Rorchive/E06/mechanics/E06-PCB.step

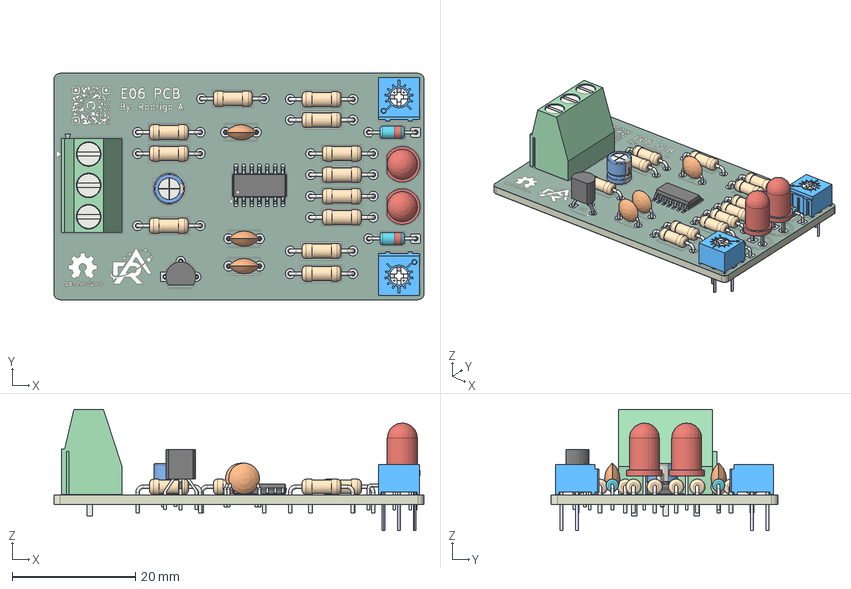
[picture p2: CAD file, 2026-11-11]
mechanics/E06-PCB.step
60.0 x 36.7 x 19.6 mm
R_Axial_DIN0207_L63mm_D25mm_P1016mm_Horizontal x 12
CP_Radial_D50mm_P200mm
C_Disc_D50mm_W25mm_P500mm x 3
3362P-1-103 x 2
D_DO-35_SOD27_P7.62mm_Horizontal x 2
TO-92_Wide
SOIC-14_3.9x8.7mm_P1.27mm
LED_D5.0mm x 2
TerminalBlock_Phoenix_MKDS-1,5-3-5.08_1x03_P5.08mm_Horizontal
E06-PCB_copper
E06-PCB_pad
E06-PCB_silkscreen
E06-PCB_soldermask x 2
E06-PCB_PCB
