Rorchive/E06/hardware/fabrication/B.Cu.pdf

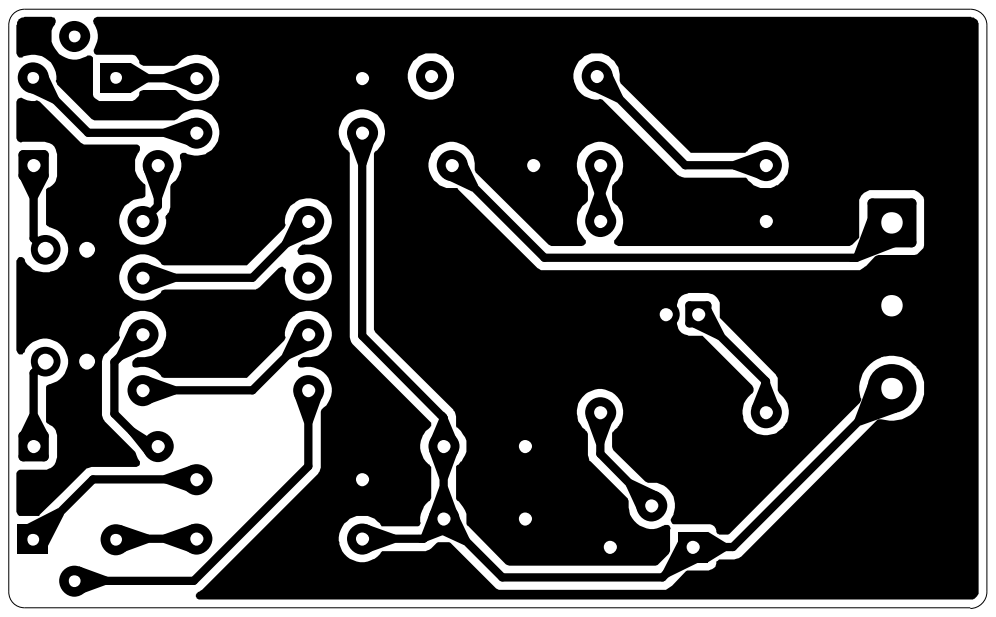
[picture p3: page 1]
