Rorchive/E06/hardware/fabrication/F.Cu.pdf

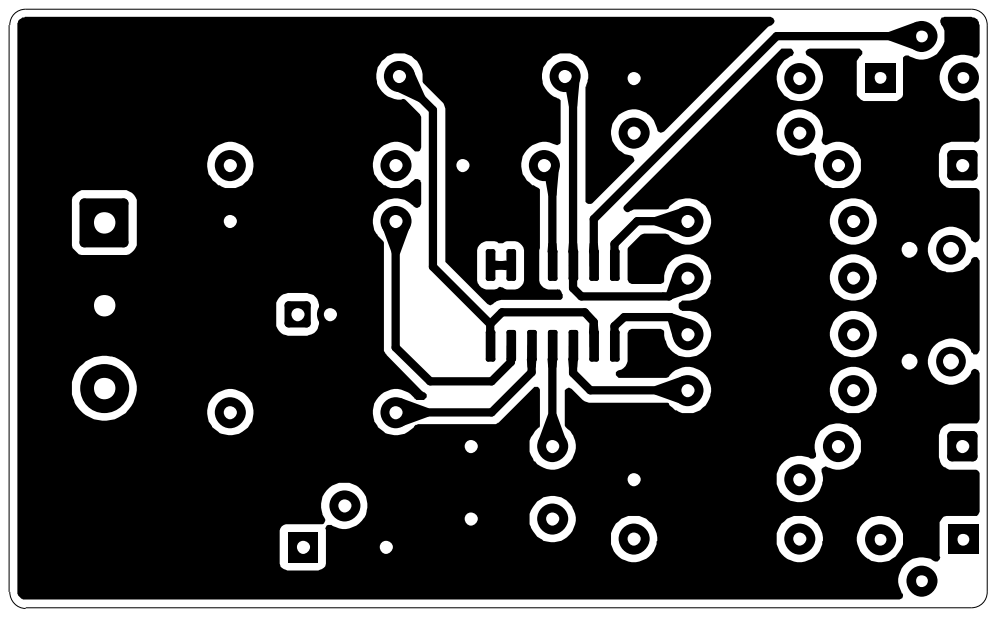
[picture p4: page 1]
