Rorchive/E06/hardware/sources/E06-PCB.kicad_pcb

## KiCad design hardware/sources/E06-PCB.kicad_pcb (2026-11-11)

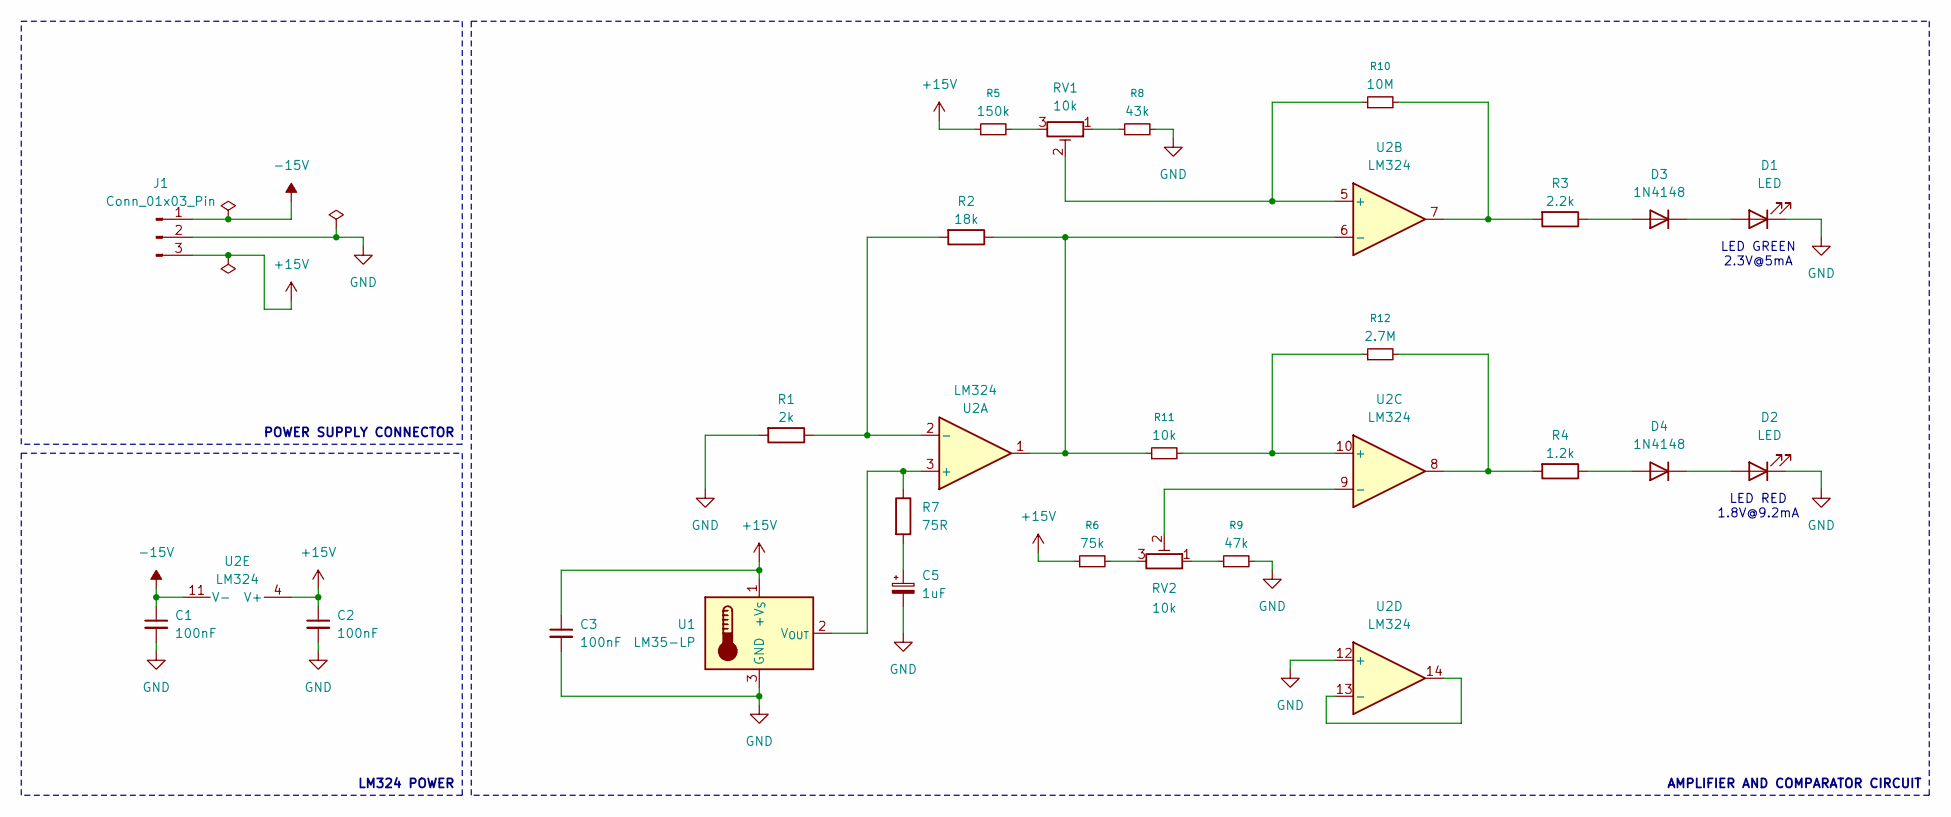
[picture p5: schematic E06-PCB.kicad_sch]

Parts:
C1, C2, C3: 100nF; C_Disc_D5.0mm_W2.5mm_P5.00mm
C5: 1uF; CP_Radial_D5.0mm_P2.00mm
D1, D2: LED; LED_D5.0mm
D3, D4: 1N4148; D_DO-35_SOD27_P7.62mm_Horizontal
J1: Conn_01x03_Pin; TerminalBlock_Phoenix_MKDS-1,5-3-5.08_1x03_P5.08mm_Horizont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
R1: 2k; R_Axial_DIN0207_L6.3mm_D2.5mm_P10.16mm_Horizontal
R2: 18k; R_Axial_DIN0207_L6.3mm_D2.5mm_P10.16mm_Horizontal
R3: 2.2k; R_Axial_DIN0207_L6.3mm_D2.5mm_P10.16mm_Horizontal
R4: 1.2k; R_Axial_DIN0207_L6.3mm_D2.5mm_P10.16mm_Horizontal
R5: 150k; R_Axial_DIN0207_L6.3mm_D2.5mm_P10.16mm_Horizontal
R6: 75k; R_Axial_DIN0207_L6.3mm_D2.5mm_P10.16mm_Horizontal
R7: 75R; R_Axial_DIN0207_L6.3mm_D2.5mm_P10.16mm_Horizontal
R8: 43k; R_Axial_DIN0207_L6.3mm_D2.5mm_P10.16mm_Horizontal
R9: 47k; R_Axial_DIN0207_L6.3mm_D2.5mm_P10.16mm_Horizontal
R10: 10M; R_Axial_DIN0207_L6.3mm_D2.5mm_P10.16mm_Horizontal
R11: 10k; R_Axial_DIN0207_L6.3mm_D2.5mm_P10.16mm_Horizontal
R12: 2.7M; R_Axial_DIN0207_L6.3mm_D2.5mm_P10.16mm_Horizontal
RV1, RV2: 10k; TRIM_3362P-1-103LF
U1: LM35-LP; TO-92_Wide
U2: LM324; SOIC-14_3.9x8.7mm_P1.27mm

Connections:
+15V: C2.1, C3.1, J1.3, R5.1, R6.1, U1.1 (+V_{S}), U2.4 (V+)
-15V: C1.1, J1.1, U2.11 (V-)
GND: C1.2, C2.2, C3.2, C5.2, D1.1 (K), D2.1 (K), J1.2, R1.2, R8.2, R9.2, U1.3 (GND), U2.12 (+)
unnamed: C5.1, R7.2
unnamed: D1.2 (A), D3.1 (K)
unnamed: D2.2 (A), D4.1 (K)
unnamed: D3.2 (A), R3.1
unnamed: D4.2 (A), R4.1
unnamed: R5.2, RV1.3
unnamed: R6.2, RV2.3
unnamed: R8.1, RV1.1
unnamed: R9.1, RV2.1
unnamed: R3.2, R10.2, U2.7
unnamed: R4.2, R12.2, U2.8
unnamed: R7.1, U1.2 (V_{OUT}), U2.3 (+)
unnamed: R1.1, R2.2, U2.2 (-)
unnamed: R10.1, RV1.2, U2.5 (+)
unnamed: R2.1, R11.1, U2.1, U2.6 (-)
unnamed: R11.2, R12.1, U2.10 (+)
unnamed: RV2.2, U2.9 (-)
unnamed: U2.13 (-), U2.14

Notes on the sheet:
LED RED 1.8V@9.2mA
LED GREEN 2.3V@5mA
AMPLIFIER AND COMPARATOR CIRCUIT
LM324 POWER
POWER SUPPLY CONNECTOR

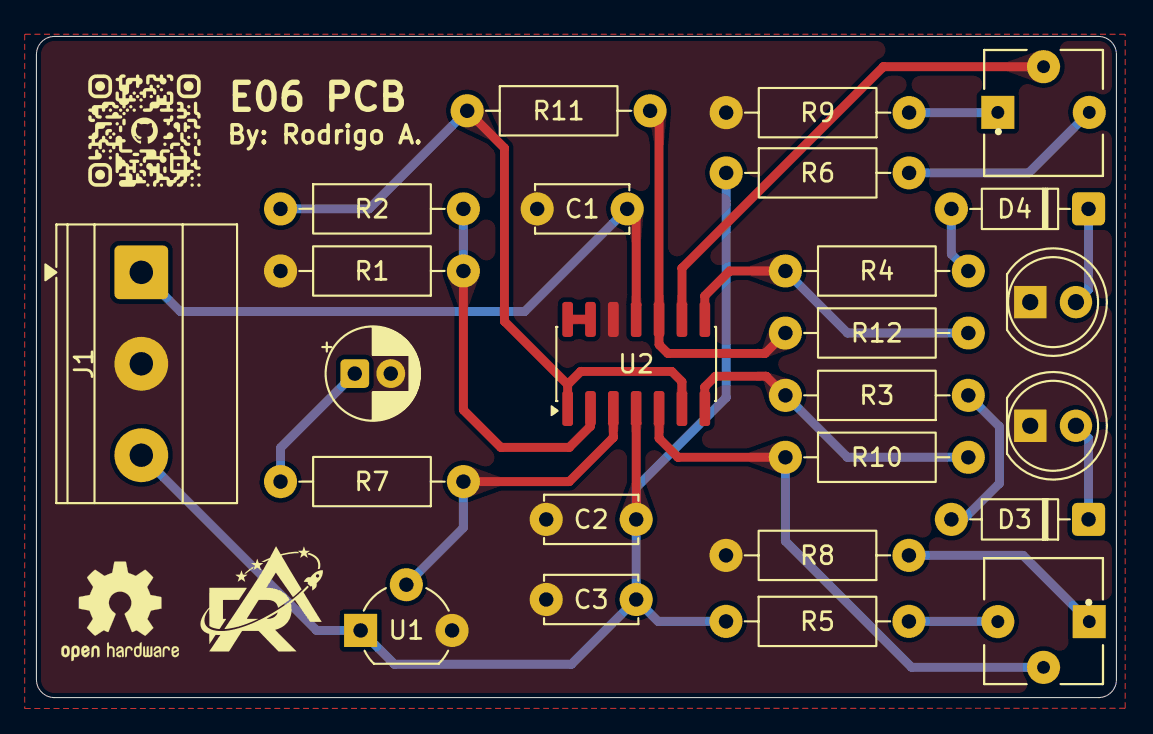
[picture p6: board E06-PCB.kicad_pcb from above]

Board: 2 copper layers, 60.0 x 36.7 mm, 25 parts (0 on the bottom side), 21 nets.
