Rorchive/E06/(commit log)

2026-11-09 feat(hardware): start PCB layout
    [E06-PCB.kicad_pcb, E06-PCB.kicad_sch]
2026-11-11 feat(hardware): finish PCB routing
    [E06-PCB.kicad_pcb, E06-PCB.kicad_sch, E06-PCB.step]
2026-11-11 fix(hardware): change trimpot
    [E06-PCB.kicad_pcb, E06-PCB.kicad_sch, E06-PCB.step]
